ianm8/UDCR2/src/README.md

Build:
 * Board: Seeed XIAO RP2350 
 * CPU Speed: 150Mhz
 * Optimize: -O2
 * USB Stack: No USB
 * Flash Size: 2MB

Some history
 * Version 1.0 initial release
 * Version 1.1 added CW filter
 * Version 1.2 fixed announce delay
 * Version 1.3 increased volume resolution
 * Version 1.4 improved tuning logic
