ianm8/UDCR2/docs/Schematic_uDCR2_2025-02-22.pdf

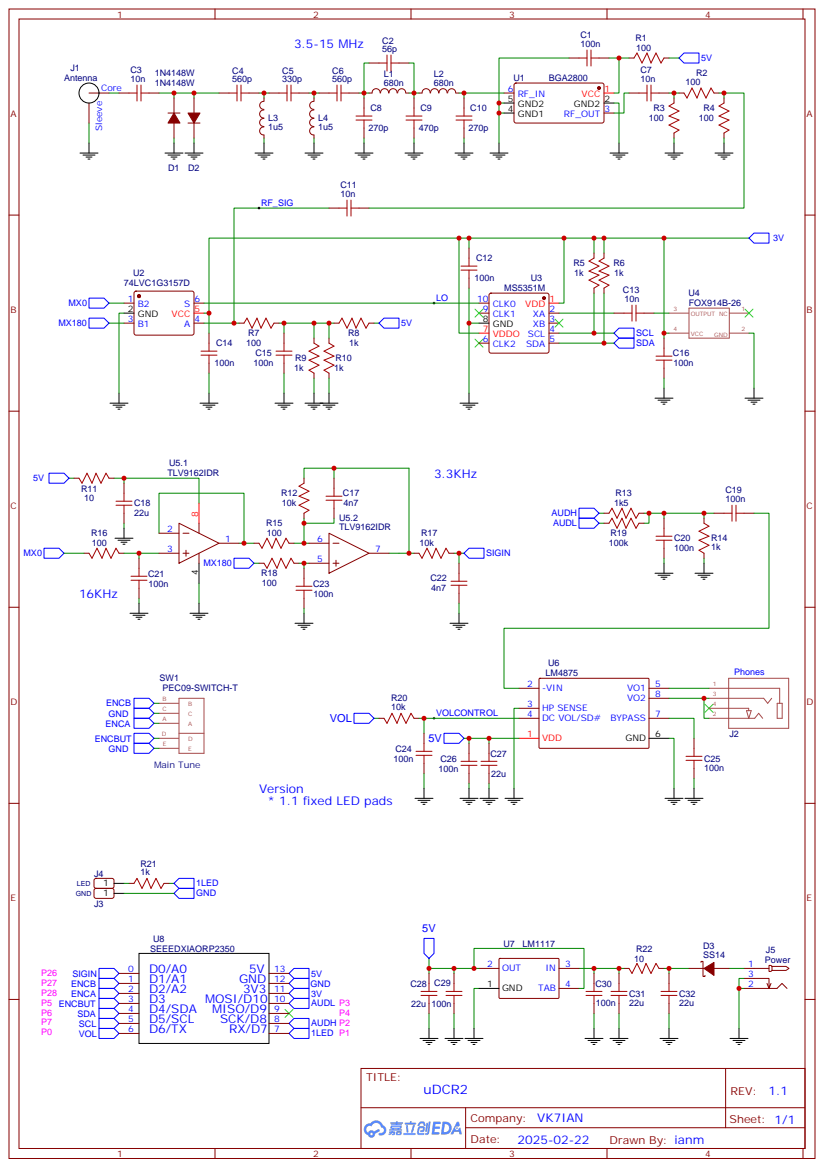
[picture p3: page 1]
