ianm8/UDCR2/src/dsp.h

/*
 * uDCR2 - Direct Conversion Receiver mk II
 *
 * Copyright (C) 2025 Ian Mitchell VK7IAN
 *
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
 * You should have received a copy of the GNU General Public License
 * along with this program.  If not, see <http://www.gnu.org/licenses/>.
 */

#ifndef DSP_H
#define DSP_H

#include "filter.h"

namespace DSP
{
  volatile static float agc_peak = 0.0f;

  static const int16_t __not_in_flash_func(agc)(const float in)
  {
    // limit gain to max of 40 (32db)
    static const float max_gain = 40.0f;
    // about 10dB per second
    static const float k = 0.99996f;

    const float magnitude = fabsf(in);
    if (magnitude > agc_peak)
    {
      agc_peak = magnitude;
    }
    else
    {
      agc_peak *= k;
    }

    // trap issues with low values
    if (agc_peak<1.0f) return (int16_t)(in * max_gain);

    // set maximum gain possible for 12 bit DAC
    const float m = 2047.0f / agc_peak;
    return (int16_t)(in * fminf(m, max_gain));
  }

  static const uint32_t __not_in_flash_func(map)(const uint32_t x,const uint32_t in_min, const uint32_t in_max,const uint32_t out_min, const float out_max)
  {
    // unsigned map
    if (x<in_min)
    {
      return out_min;
    }
    if (x>in_max)
    {
      return out_max;
    }
    return (x - in_min) * (out_max - out_min) / (in_max - in_min) + out_min;
  }

  static const uint32_t __not_in_flash_func(smeter)(void)
  {
    // assume S9 = 86 in 14 bits (35mv PP)
    volatile static uint32_t s = 0;
    volatile static uint32_t agc_update = 0;
    //static const float S0_sig = 30.0f; // not bad
    //static const float S0_sig = 5.0f; // too low, LED on all the time with antenna noise
    //static const float S0_sig = 10.0f; // too low, LED on all the time with antenna noise
    static const float S0_sig = 20.0f;
    static const float S9_sig = 86.0f;
    static const uint32_t sig_min = (uint32_t)(log10f(S0_sig) * 1024.0f);
    static const uint32_t sig_max = (uint32_t)(log10f(S9_sig) * 1024.0f);
    static const uint32_t led_min = 0ul;
    static const uint32_t led_max = 255ul;
    const uint32_t now = millis();
    if (now>agc_update)
    {
      agc_update = now + 20ul;
      s = 0;
      const float peak = agc_peak;
      if (peak>1.0f)
      {
        const uint32_t log_peak = (uint32_t)(log10f(peak) * 1024.0f);
        s = map(log_peak,sig_min,sig_max,led_min,led_max);
      }
    }
    return s;
  }

  static const int16_t __not_in_flash_func(process_ssb)(const float s)
  {
    // remove DC
    // 200-2400 BPF
    // AGC
    // convert to fixed (12 bit)
    const float dc = FILTER::dcf(s);
    const float v = FILTER::lpf_2400(dc);
    return agc(v * 8192.0f);
  }

  static const int16_t __not_in_flash_func(process_cw)(const float s)
  {
    // 600-800 BPF
    // AGC
    // convert to fixed (12 bit)
    const float v = FILTER::bpf_700f(s);
    return agc(v * 8192.0f);
  }
}

#endif
