ianm8/UDCR2/(commit log)

2025-02-22 Schematic Version 1.1
2025-02-23 PCB top and bottom
